Moduled-Smart-Home/ceiling-fan-control_pic16f628a/hardware/CeilingFanControl/CeilingFanControl(without zones)-Cobre traseira.dxf

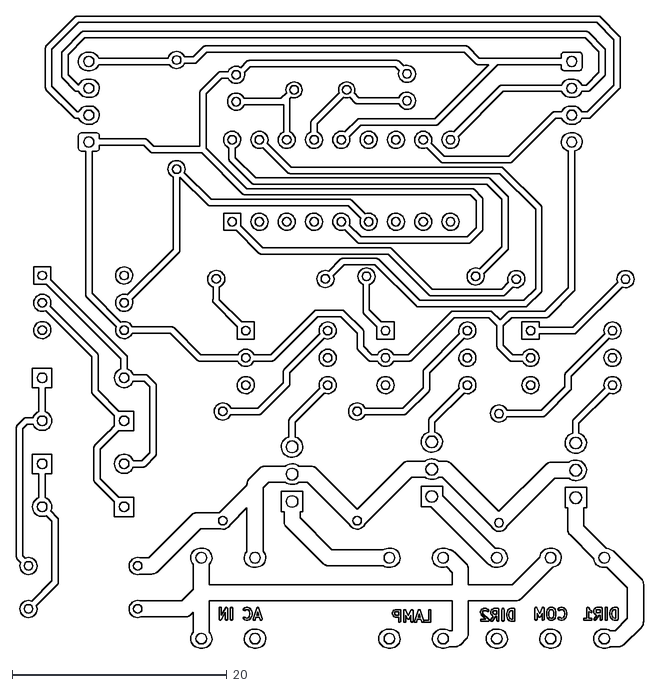
[picture p1: CAD file, 2022-02-13]
hardware/CeilingFanControl/CeilingFanControl(without zones)-Cobre traseira.dxf
58.3 x 58.8
