Moduled-Smart-Home/ceiling-fan-control_pic16f628a/hardware/CeilingFanControl/CeilingFanControl(without zones)-Cortes contorno.dxf

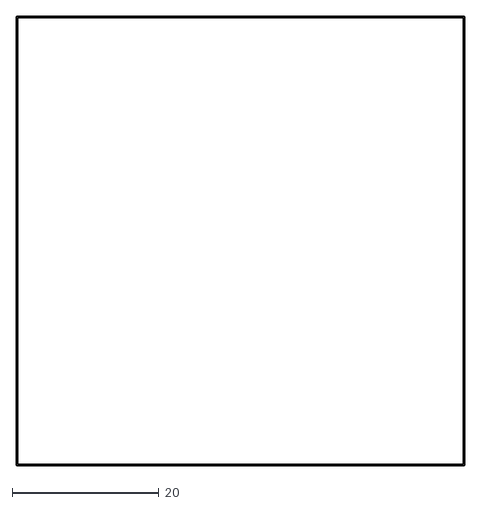
[picture p2: CAD file, 2022-02-13]
hardware/CeilingFanControl/CeilingFanControl(without zones)-Cortes contorno.dxf
61.0 x 61.2
