Moduled-Smart-Home/ceiling-fan-control_pic16f628a/hardware/CeilingFanControl/CeilingFanControl-Cobre traseira.dxf

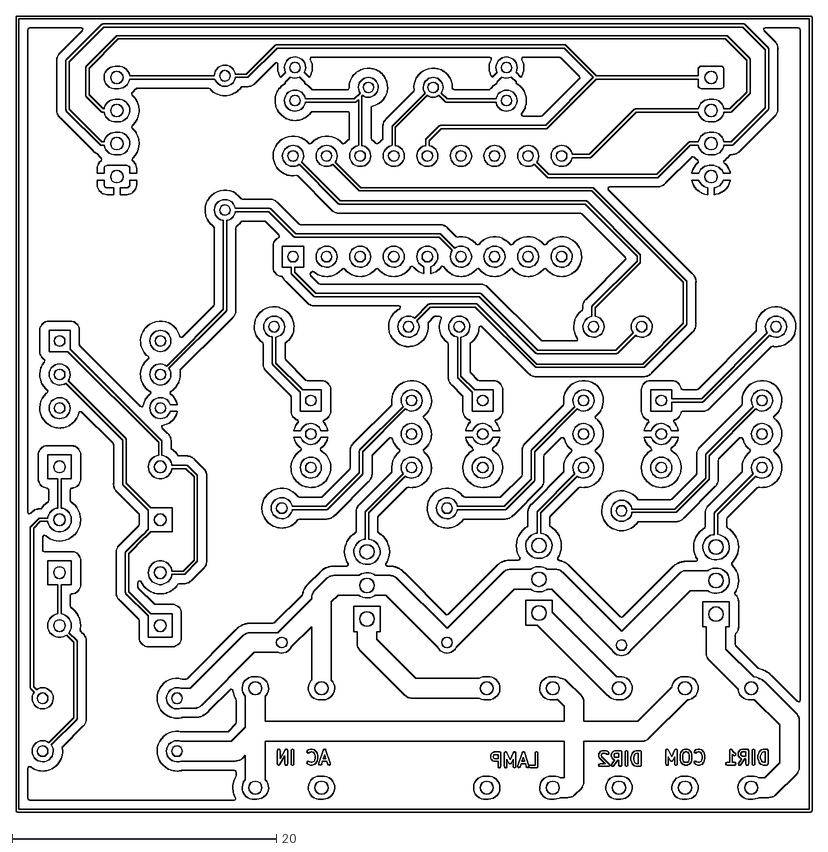
[picture p3: CAD file, 2022-02-08]
hardware/CeilingFanControl/CeilingFanControl-Cobre traseira.dxf
60.2 x 60.2
