Moduled-Smart-Home/ceiling-fan-control_pic16f628a/hardware/CeilingFanControl/CeilingFanControl.kicad_pcb

## KiCad design hardware/CeilingFanControl/CeilingFanControl.kicad_pcb (2024-12-15)

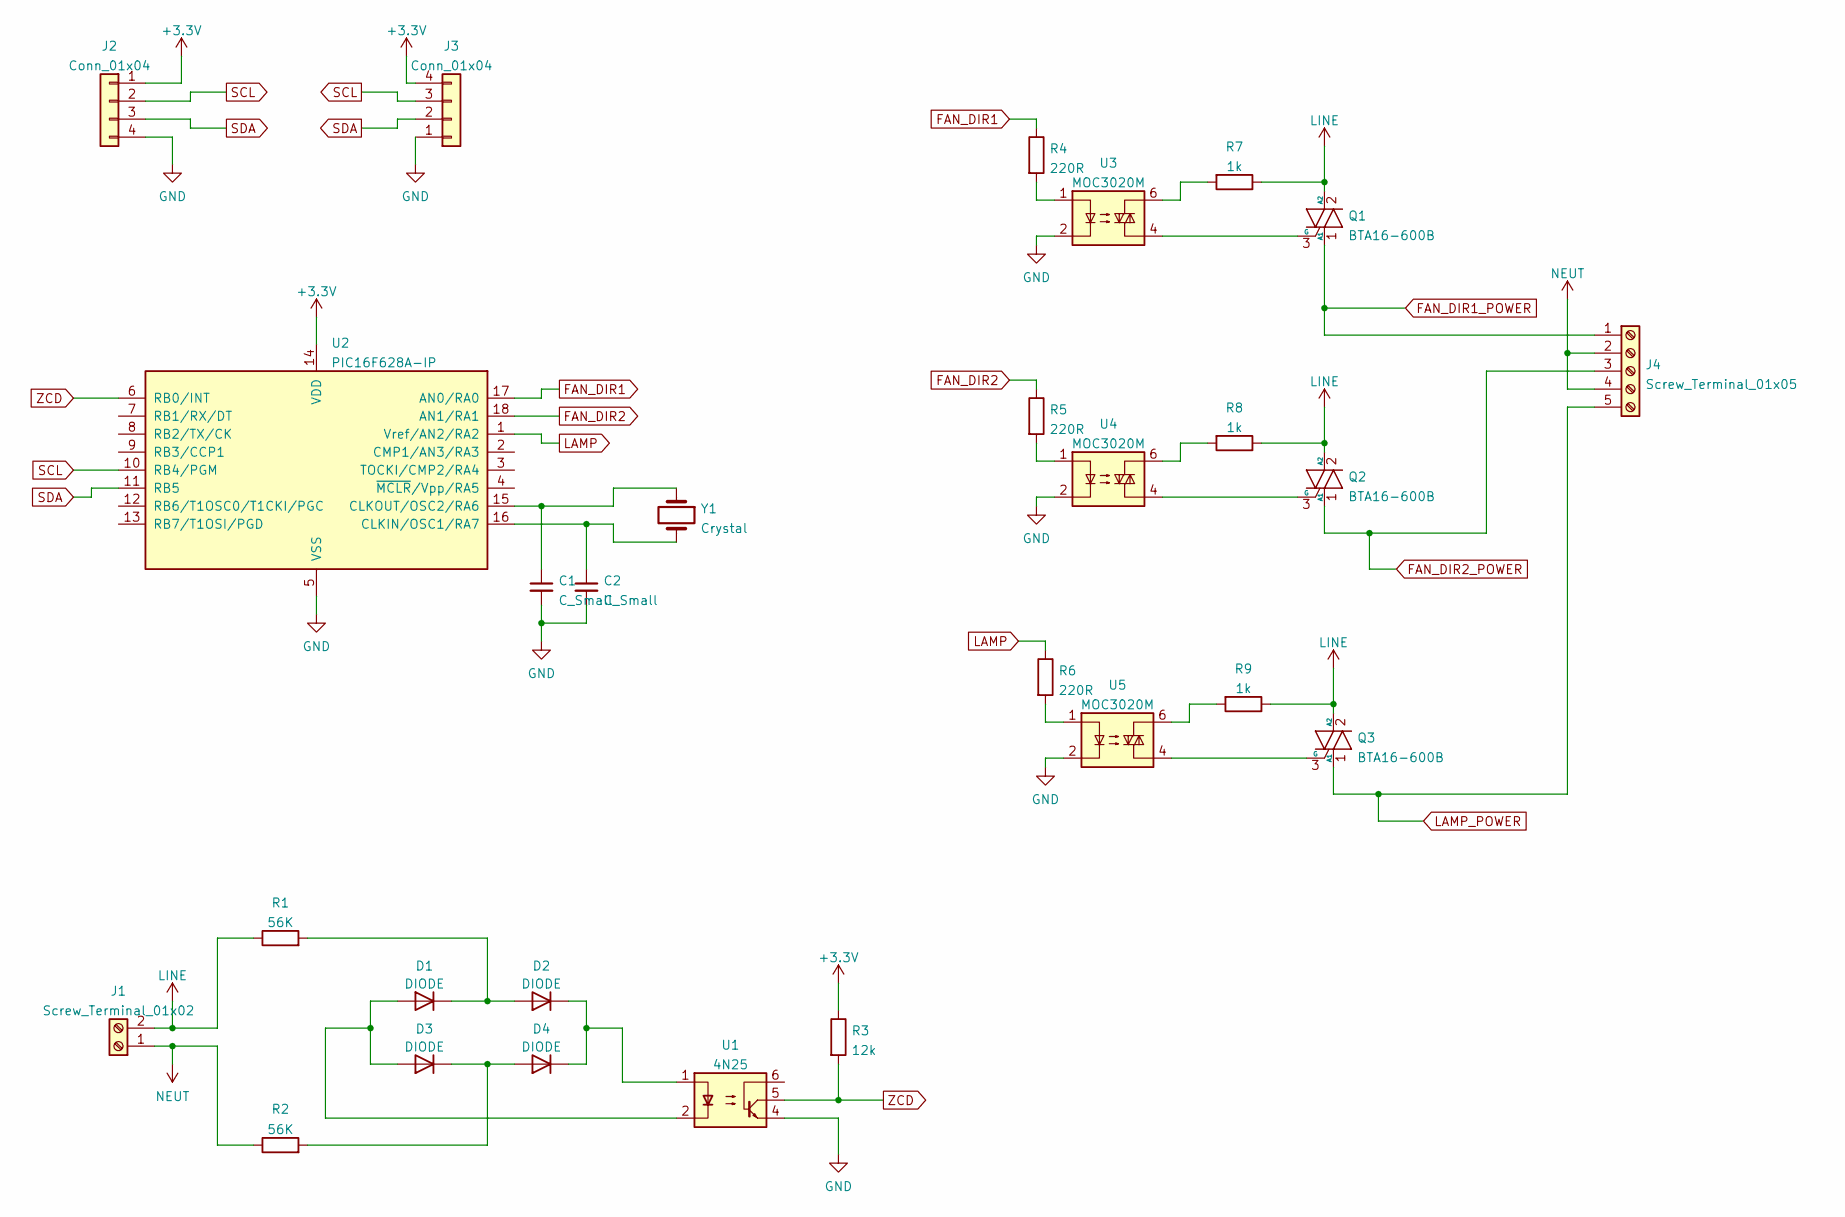
[picture p4: schematic CeilingFanControl.kicad_sch]

Parts:
C1, C2: C_Small; C_Disc_D3.0mm_W1.6mm_P2.50mm
D1, D2, D3, D4: DIODE; D_A-405_P7.62mm_Horizontal
J1: Screw_Terminal_01x02; Connector_Spring_Terminal_Block_5.00mm_2P_KF142V
J2, J3: Conn_01x04; JST_EH_S4B-EH_1x04_P2.50mm_Horizontal
J4: Screw_Terminal_01x05; Connector_Spring_Terminal_Block_5.00mm_5P_KF142V
Q1, Q2, Q3: BTA16-600B; TO-220-3_Vertical
R1, R2: 56K; R_Axial_DIN0207_L6.3mm_D2.5mm_P10.16mm_Horizontal
R3: 12k; R_Axial_DIN0207_L6.3mm_D2.5mm_P10.16mm_Horizontal
R4, R5, R6: 220R; R_Axial_DIN0207_L6.3mm_D2.5mm_P10.16mm_Horizontal
R7, R8, R9: 1k; R_Axial_DIN0207_L6.3mm_D2.5mm_P10.16mm_Horizontal
U1: 4N25; DIP-6_W7.62mm
U2: PIC16F628A-IP; DIP-18_W7.62mm
U3, U4, U5: MOC3020M; DIP-6_W7.62mm
Y1: Crystal; Crystal_HC18-U_Vertical

Connections:
+3V3: J2.1, J3.4, R3.1, U2.14 (VDD)
FAN_DIR1: R4.1, U2.17 (AN0/RA0)
FAN_DIR1_POWER: J4.1, Q1.1 (A1)
FAN_DIR2: R5.1, U2.18 (AN1/RA1)
FAN_DIR2_POWER: J4.3, Q2.1 (A1)
GND: C1.2, C2.2, J2.4, J3.1, U1.4, U2.5 (VSS), U3.2, U4.2, U5.2
LAMP: R6.1, U2.1 (Vref/AN2/RA2)
LAMP_POWER: J4.5, Q3.1 (A1)
LINE: J1.2, Q1.2 (A2), Q2.2 (A2), Q3.2 (A2), R1.1, R7.1, R8.1, R9.1
NEUT: J1.1, J4.2, J4.4, R2.1
unnamed: C1.1, U2.15 (CLKOUT/OSC2/RA6), Y1.1
unnamed: C2.1, U2.16 (CLKIN/OSC1/RA7), Y1.2
unnamed: D1.1 (K), D2.2 (A), R1.2
unnamed: D1.2 (A), D3.2 (A), U1.2
unnamed: D2.1 (K), D4.1 (K), U1.1
unnamed: D3.1 (K), D4.2 (A), R2.2
unnamed: Q1.3 (G), U3.4
unnamed: Q2.3 (G), U4.4
unnamed: Q3.3 (G), U5.4
unnamed: R4.2, U3.1
unnamed: R5.2, U4.1
unnamed: R6.2, U5.1
unnamed: R7.2, U3.6
unnamed: R8.2, U4.6
unnamed: R9.2, U5.6
SCL: J2.2, J3.3, U2.10 (RB4/PGM)
SDA: J2.3, J3.2, U2.11 (RB5)
ZCD: R3.2, U1.5, U2.6 (RB0/INT)

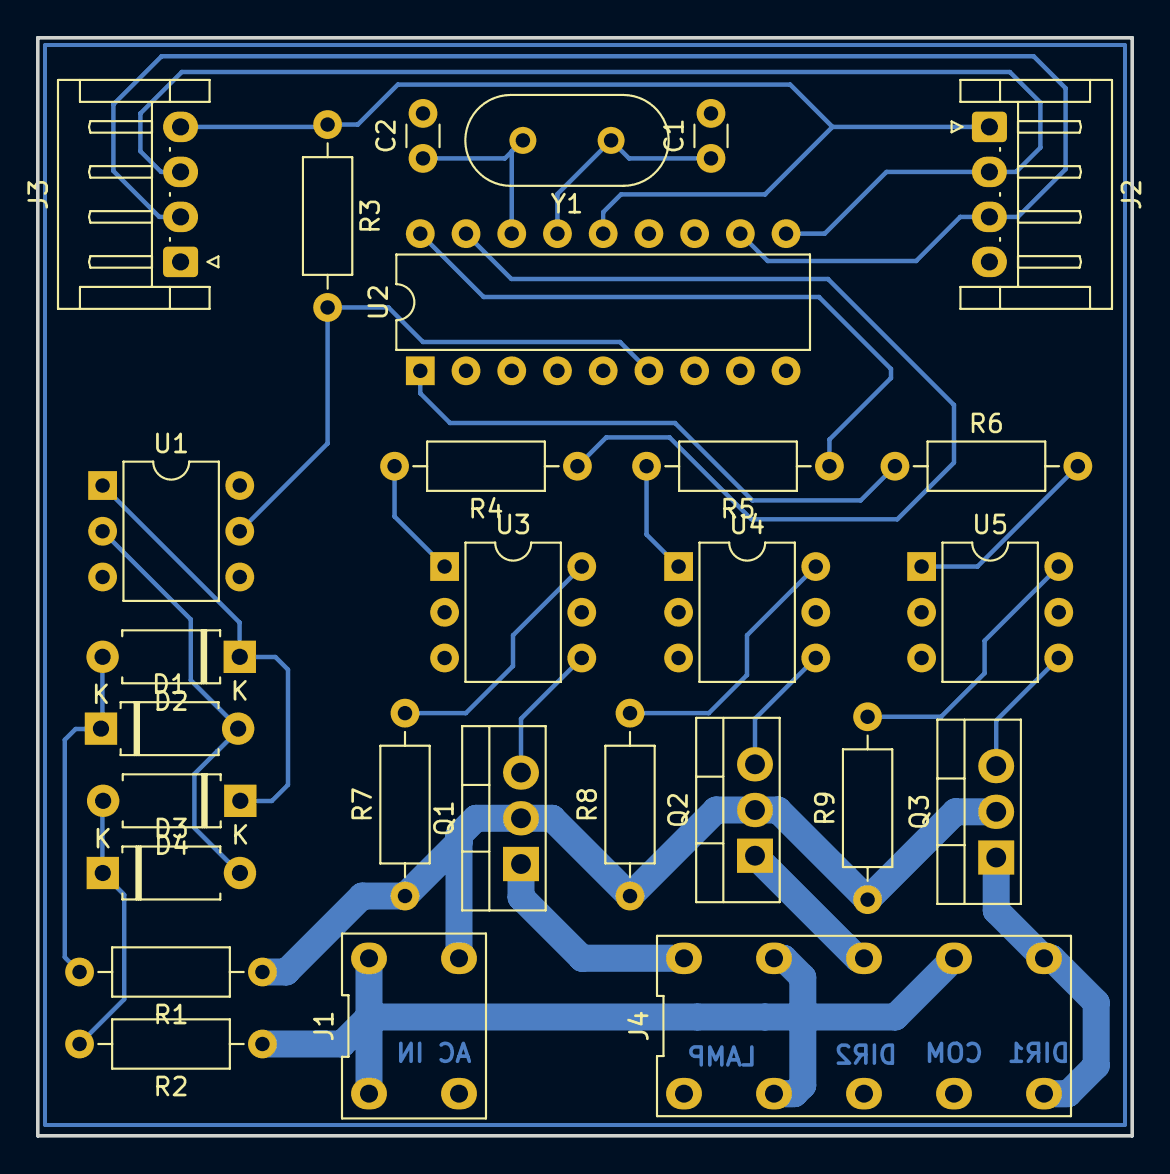
[picture p5: board CeilingFanControl.kicad_pcb from above]

Board: 2 copper layers, 60.8 x 61.0 mm, 28 parts (0 on the bottom side), 28 nets.
