Moduled-Smart-Home/ceiling-fan-control_pic16f628a/firmware/main.c

/*
 * File:   newmain.c
 * Author: conrado
 *
 * Created on December 12, 2021, 12:20 AM
 */

// PIC16F628A Configuration Bit Settings

// 'C' source line config statements

// CONFIG
#pragma config FOSC = HS    // Oscillator Selection bits (HS oscillator: High-speed crystal/resonator on RA6/OSC2/CLKOUT and RA7/OSC1/CLKIN)
#pragma config WDTE = OFF       // Watchdog Timer Enable bit (WDT disabled)
#pragma config PWRTE = ON       // Power-up Timer Enable bit (PWRT enabled)
#pragma config MCLRE = OFF      // RA5/MCLR/VPP Pin Function Select bit (RA5/MCLR/VPP pin function is digital input, MCLR internally tied to VDD)
#pragma config BOREN = OFF      // Brown-out Detect Enable bit (BOD disabled)
#pragma config LVP = OFF         // Low-Voltage Programming Enable bit (RB4/PGM pin has PGM function, low-voltage programming enabled)
#pragma config CPD = OFF        // Data EE Memory Code Protection bit (Data memory code protection off)
#pragma config CP = OFF         // Flash Program Memory Code Protection bit (Code protection off)

// #pragma config statements should precede project file includes.
// Use project enums instead of #define for ON and OFF.

#include <xc.h> 
#define _XTAL_FREQ 20000000

#include "i2c.h"

PORTAbits_t LATCHA;
PORTBbits_t LATCHB, LATCHB_prev;

#define LED LATCHA.RA3
#define FAN_DIR1 LATCHA.RA0
#define FAN_DIR2 LATCHA.RA1
#define LAMP LATCHA.RA2

//#define TIME_TRIGG_us 6500
#define TIME_HOLD_us 1000
#define TIME_TRIGG_MAX_us 7333
#define TIME_TRIGG_MIN_us 0

#define TIME_TRIGG_POT1_us 6500
#define TIME_TRIGG_POT2_us 4000
#define TIME_HOLD_us 1000

static unsigned short TICKS_PER_US = _XTAL_FREQ / (4 * 1000000);
static unsigned short TIMER_SETUP_POT, TIMER_SETUP_POT1, TIMER_SETUP_POT2, TIMER_SETUP_HOLD;

typedef enum {ZERO_CROSSED, TRIGGED, READY} triac_state_t;
triac_state_t triac_fan;
triac_state_t triac_lamp;

typedef enum {OFF, ON_DIR1, ON_DIR2} fan_state_t;
fan_state_t fan_state;

void toggleLED(void) {
    LED = !LED;
    PORTAbits = LATCHA;
}

void setLED(unsigned char value) {
    LED = value;
    PORTAbits = LATCHA;
}

void setLAMP(unsigned char value) {
    LAMP = value;
    PORTAbits = LATCHA;
}

void setFanDir1(unsigned char value) {
    FAN_DIR2 = 0;
    FAN_DIR1 = value;
    PORTAbits = LATCHA;
}

void setFanDir2(unsigned char value) {
    FAN_DIR1 = 0;
    FAN_DIR2 = value;
    PORTAbits = LATCHA;
}

void  __interrupt(high_priority) myHighIsr(void) {
    if (RBIE && RBIF) {
        INTE = 0;
        TMR1IE = 0;
        LATCHB = PORTBbits;
        i2cInterruptHandle(LATCHB.RB4, LATCHB.RB5);
        RBIF=0;
        INTE = 1;
        TMR1IE = 1;
    }
    
    if (INTE && INTF) {
        INTF=0;
        
        if (fan_state != OFF) {
            TMR1 = TIMER_SETUP_POT;
            triac_fan = ZERO_CROSSED;
            TMR1IE = 1; //enable TMR1 interrupt
            TMR1ON = 1; //start TMR1
        }        
    }
    
    if (TMR1IE && TMR1IF) {
        TMR1IF = 0;
        
        if (triac_fan == ZERO_CROSSED) {
            switch (fan_state) {
                case ON_DIR1:
                    setFanDir1(1);
                    break;
                    
                case ON_DIR2:
                    setFanDir2(1);
                    break;
            }

            TMR1 = TIMER_SETUP_HOLD;
            triac_fan = TRIGGED;
        }
        
        else if (triac_fan == TRIGGED) {
            setFanDir1(0);
            setFanDir2(0);
            triac_fan = READY;
            TMR1IE = 0; //disable TMR1 interrupt
            TMR1ON = 0; //stop TMR1
        }
    }
}


void main(void) {
    TIMER_SETUP_POT = 65535 - 0.9*TIME_TRIGG_MAX_us*TICKS_PER_US; // start with minimum power
    TIMER_SETUP_HOLD = 65535 - (TIME_HOLD_us * TICKS_PER_US);
    
     // XTAL Oscilator
    TRISAbits.TRISA6 = 1;
    TRISAbits.TRISA7 = 1;
    
    // Configuration LED e MOC
    PCONbits.OSCF=1;
    TRISAbits.TRISA3 = 0; //Output - LED
    TRISAbits.TRISA0 = 0; //Output - FAN_DIR1
    TRISAbits.TRISA1 = 0; //Output - FAN_DIR2
    TRISAbits.TRISA2 = 0; //Output - LAMP
    
    // Configuration Zero Crossing Interrupt
    TRISBbits.TRISB0 = 1;
    INTCONbits.GIE=1;
    INTCONbits.INTE=1;
    OPTION_REGbits.INTEDG=1;
    
    LATCHA = PORTAbits; // Initialize Latch with actual port values
    
    //TIMER1 config
    TMR1ON = 0; //ensure tmr1 is stopped
    TMR1CS = 0; //timer mode
    PEIE = 1; //enable peripheral interrupt
    
    T1CKPS0 = 0; //prescale 1:1
    T1CKPS1 = 0;
    
    setSlaveAddress8bits(0xAA);
    
    DATA_RECEIVED = 0;
    
    fan_state = OFF;
    triac_fan = READY;
    
    int ret;
    ret = startI2C();
    
    setLED(0);
    
    setLAMP(1); 
    
    while(1) {      

//        if (i2c_state == REC_DATA) {
//            toggleLED();
//        }
        
        if (DATA_RECEIVED == 1) {

            switch (cmd) {
                case LED_OFF:
                   setLED(0);
                   break;
                
                case LED_ON:
                    setLED(1);
                    break;
                    
                case FAN_OFF:
                    fan_state = OFF;
                    break;
                    
                case FAN_ON_DIR1:
                    fan_state = ON_DIR1;
                    break;
                    
                case FAN_ON_DIR2:
                    fan_state = ON_DIR2;
                    break;
                        
                case POT1:
                    TIMER_SETUP_POT = 65535 - 0.95*TIME_TRIGG_MAX_us*TICKS_PER_US;
                    break;
                    
                case POT2:
                    TIMER_SETUP_POT = 65535 - 0.90*TIME_TRIGG_MAX_us*TICKS_PER_US;
                    break;
                
                case POT3:
                    TIMER_SETUP_POT = 65535 - 0.85*TIME_TRIGG_MAX_us*TICKS_PER_US;
                    break;
                
                case POT4:
                    TIMER_SETUP_POT = 65535 - 0.65*TIME_TRIGG_MAX_us*TICKS_PER_US;
                    break;
                    
                case POT5:
                    TIMER_SETUP_POT = 65535 - 0.30*TIME_TRIGG_MAX_us*TICKS_PER_US;
                    break;
                    
                case LAMP_ON:
                    setLAMP(1);
                    break;
                    
                case LAMP_OFF:
                    setLAMP(0);
                    break;
            }
            
            DATA_RECEIVED = 0;
        }
    }
    
    return;
}
