Moduled-Smart-Home/ceiling-fan-control_pic16f628a/(commit log)

2022-01-30 Implementa teste 1 canal de controle 2 níveis de potência
2022-01-31 Melhora forma de calculo de setup de TIMER1
2022-02-01 Adiciona mais comandos de teste
2022-02-01 Adicona mais niveis de potencia
2022-02-08 Ajusta tempos de disparo
2022-02-08 Primeira versão da placa
    [CeilingFanControl-Cobre traseira.dxf, CeilingFanControl.kicad_pcb, CeilingFanControl.kicad_sch]
2022-02-13 Adiciona controle do canal de lampada
2022-02-13 PCI com e sem zonas de GND
    [CeilingFanControl(without zones)-Cobre traseira.dxf, CeilingFanControl(without zones)-Cortes contorno.dxf, CeilingFanControl(without zones).kicad_pcb]
2023-03-05 Commit befora creating tag
    [CeilingFanControl(without zones).kicad_pcb, CeilingFanControl.kicad_pcb, CeilingFanControl.kicad_sch]
2024-12-15 commit before system update
    [CeilingFanControl(without zones)-NPTH-drl_map.gbr, CeilingFanControl(without zones)-NPTH.drl, CeilingFanControl(without zones)-PTH-drl_map.gbr, CeilingFanControl(without zones)-PTH.drl, CeilingFanControl-Cobre traseira.gbr, CeilingFanControl-Cortes contorno.gbr, CeilingFanControl-NPTH-drl-drl_map.gbr, CeilingFanControl-NPTH-drl.gbr]
